herraa1/WonderTANG/(commit log)

2023-11-19 [kicad] Fix board edge clearance violation errors
    PCB edge connectors pad types are currently declared as SMD instead of
    Edge Connector which causes 49 board edge clearance violation errors
    when running the DRC (Design Rules Checker).
    Fix those by declaring the edge connectors pad types as Edge Connector.
    [WonrderTANG.kicad_pcb]
2023-11-19 [kicad] Fix CARTRIDGE_MSX footprint board edge clearance violation errors
    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
2023-11-19 [kicad] Fix silkscreen overlap between Q1 and R5
    [WonrderTANG.kicad_pcb]
2023-11-19 [kicad] Fix text thickness out of range errors for U5
    Fixes text thickness out of range errors for "HDMI"
    and "USB-C" texts of U5 by increasing text thickness
    from 0.1 to 0.15.
    [WonrderTANG.kicad_pcb]
2023-11-19 [kicad] Fix silkscreen clipped by solder mask for cartridge pads
    Text for pads 3 "CS12" and 4 "SLTSL" fall within one of the holes
    used to fix the cartridge board to the cartridge case.
    Make those texts visible again by reducing text width so that they
    do not extend into the cartridge board hole.
    [WonrderTANG.kicad_pcb]
2023-11-19 [kicad] show value for U4
    All SN74LVC245AN footprints show its value except U4.
    Fix that by adding its value to the silkscreen layer.
    [WonrderTANG.kicad_pcb]
2023-11-19 [kicad] Use alternate audio connector SJ1-3525N
    Exchange the SJ1-3533NG mono audio connector with the more common
    (at least in Europe and some large asian shops) SJ1-3525N stereo
    connector, keeping the same orientation.
    To fit the new connector the board led is slightly moved too.
    [WonrderTANG.kicad_pcb, WonrderTANG.kicad_sch]
2023-11-19 [kicad] Mark board as F1 fork
    Identify this board as a new fork to avoid confusion with the stock
    board by slightly changing the silkscreen identification.
    [WonrderTANG.kicad_pcb]
2023-11-29 Release 2023 V1.01b.F1
    Add copper planes for final fabrication.
    [WonrderTANG.kicad_pcb]
2024-04-28 [kicad] Silkscreen updates for cartridge pads
    Mark active low signals BDIR,CS1,CS2,CS12,INT,IRQ,M1,MRQ,RD,RFSH,RST,SLTSL,WAIT,WR with a bar above them.
    Add voltage suffix V to +5, +12 and -12 signals.
    Add pad number to pad 43.
    Add pad number to pad 44.
    Name each SW pad with its own names SW1 and SW2.
    Rename BDIR to BUSDIR.
    Rename CLK to CLOCK.
    Rename RST to RESET.
    Rename SND to SOUNDIN.
    [WonrderTANG.kicad_pcb]
2024-04-28 [kicad] Fix /CART_5V net width
    Update the PCB to bring /CART_5V in sync with the schematic.
    Apply the power netclass width to /CART_5V as it is currently using a
    smaller width than the rest of power nets (from the cartridge pads to the
    D2 diode).
    Add clearance when needed to account for the increase in net width.
    [WonrderTANG.kicad_pcb]
2024-04-28 [kicad] Use alternate audio connector SJ1-3525N
    This modification also allows to keep the audio connector within
    the standard cartridge case depth.
    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
    [WonrderTANG.kicad_pcb, WonrderTANG.kicad_sch]
2024-04-28 [kicad] Add copper fill for GND
    Add copper fill on the bottom layer for GND.
    It may provide added signal integrity.
    [WonrderTANG.kicad_pcb]
2024-04-28 [kicad] Mark board as V1.01c.F1 fork
    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
    [WonrderTANG.kicad_pcb]
2024-06-13 fpga: reverse int_n logic for board V1.02d and build bitstream
    [top.v]
